chrisdsa/BMS/README.md

# BMS
