chrisdsa/BMS/DOC/Conception/Main.tex

\documentclass[12pt,letterpaper]{article}
\usepackage{hyperref}
\hypersetup{colorlinks=true,allcolors=black}
\usepackage[utf8]{inputenc}
\usepackage[frenchb]{babel}
\usepackage[T1]{fontenc}
\usepackage{ae,aecompl}
\usepackage{pslatex}
\usepackage[top=2cm, bottom=2cm, left=2cm, right=2cm]{geometry}
\usepackage{hhline}
\usepackage{amsmath}
\usepackage{pgfplots}
\pgfplotsset{compat=newest}
\usepackage{multicol}
\usepackage{graphicx}
\graphicspath{{Images/}}
\hyphenpenalty=100
\usepackage{caption}
\usepackage{enumitem}
\usepackage{textcomp}
% Pour multicol (Align top)
\raggedcolumns
% Pour enlever l'indentation et avoir un espace entre les paragraphes
%\usepackage[parfill]{parskip}
\usepackage{float}
\floatstyle{plaintop}
\restylefloat{table}

% Page de garde
\newcommand{\blankpage}{
	\newpage
	\thispagestyle{empty}
	\mbox{}
	\newpage
}

\begin{document}
	
	%====== Page de presentation ======%
	\hypersetup{pageanchor=false}
	\input{./page_presentation.tex}
	\blankpage
	%====== Table des matieres ======%
	\pagenumbering{roman}
	\hypersetup{pageanchor=true}
	\tableofcontents
	%\listoftables
	%\listoffigures	
	\newpage

%====================== INCLUSION DES PARTIES ======================
	\pagenumbering{arabic}
	%====== Introduction ======%	
	\input{Introduction/Introduction.tex}
	%====== Introduction: Rappel de mise en contexte ======%
	\input{Objectifs/Protection_modules.tex}
	%====== Fonctionnalité : Lecture de la tension des modules  ======%
	\input{Fonctionnalites/Lecture_Tension_Module.tex}
	%====== Fonctionnalité : Lecture de la tension de la batterie  ======%
	\input{Fonctionnalites/Lecture_Tension_Batterie.tex}
	%====== Fonctionnalité : Lecture de du courant  ======%
	\input{Fonctionnalites/Lecture_Courant.tex}
	%====== Fonctionnalité : Lecture de la température  ======%
	\input{Fonctionnalites/Lecture_Temperature.tex}
	%====== Fonctionnalité : Détection des seuils et sécurisation de la batterie  ======%
	\input{Fonctionnalites/Detection_seuils_Securisation.tex}
	%====== Fonctionnalité : Controle Contacteur  ======%
	\input{Fonctionnalites/Controle_Contacteurs.tex}
	%====== Fonctionnalité : Avertir l'utilisateur  ======%
	\input{Fonctionnalites/Signalisation_Erreur.tex}	
	%====== Fonctionnalité : Réinitialisation  ======%
	\input{Fonctionnalites/Reinitialisation_Systeme.tex}
	
	%====== Objectif : Balancement des modules ======%
	\input{Objectifs/Balancement.tex}
	\input{Fonctionnalites/Balancement.tex}

	%====== Objectif : Compatibilité avec le BMS présentement utilisé ======%
	\input{Objectifs/Compatibilite.tex}	
	
	%====== Objectif : Facilité les manipulations lors des vérifications techniques ======%
	\input{Objectifs/Manipulations_Verifications_Techniques.tex}

	%====== Architecture ======%
	\input{Architecture/Architecture.tex}
	\input{Architecture/Choix_Technologiques.tex}
	\input{Architecture/Logiciel.tex}
	\input{Architecture/Diagrammes_Fonctionnels.tex}

%====================== Bibliographie ======================

	\begin{thebibliography}{10}
	
	\bibitem{cahier_charge} 
	Christian Daigneault-St-Arnaud, Julien Gagnon-Bourassa, Olivier Cusson-Larocque. \textit{Cahier des charges, Système de protection et de gestion de batterie Li-ion}. \par	
	
	\bibitem{HCNR201} 
	Avago Technologies. \textit{HCNR200 and HCNR201 Data Sheet}.\\ \texttt{\url{https://docs.broadcom.com/docs/AV02-0886EN}}\par
	
	\bibitem{PGA281} 
	Texas Instruments. \textit{PGA281 Data Sheet}.\\ \texttt{\url{http://www.ti.com/lit/ds/symlink/pga281.pdf}}\par

	\bibitem{System_Approach} 
	Phillip Weicker. \textit{A System Approach to Lithium-Ion Battery Management}.\\ \texttt{2014 ARTECH HOUSE}\par	
	
	\bibitem{Lithium_Balance} 
	Lithium Balance. \textit{Battery Management System - Version V6}.\\ \texttt{Application Engineering Manual}\par	

	\bibitem{ASC2018} 
	The Innovators Educational Foundation. \textit{American Solar Challenge 2018 Regulations Revision A}.\\ \texttt{http://americansolarchallenge.org/ASC/wp-content/uploads/2016/08/ASC2018-Regs-External-Revision-A.pdf}\par	
	
	\bibitem{GigavacHX21} 
	Gigavac. \textit{Spécification technique du contacteur HX21}.\\ \texttt{http://www.gigavac.com/sites/default/files/hx21.pdf}\par	

	\bibitem{LiIonBms} 
	Davide Andrea. \textit{Li-Ion BMS: A design guide to DC precharge circuits}.\\ \texttt{http://liionbms.com/php/precharge.php}\par	

	\end{thebibliography}	
	
\end{document}
