chrisdsa/BMS/DOC/Conception/page_presentation.tex

%================ Page titre ================

\title{
	\textbf{Cahier de conception} \\
	\vspace{2cm}
	Système de protection et de gestion de batterie Li-ion	
	}
\author{
	Daigneault-St-Arnaud, Christian, DAIC30099006 \\
	Gagnon-Bourassa, Julien, GAGJ23108601 \\
	Cusson-Larocque, Olivier, CUSO09048905	
}
\newcommand{\cours}{ELE791 - Projets spéciaux }
\newcommand{\prof}{Deslandes, Dominic}

\makeatletter
\begin{titlepage}

	%\pagenumbering{Alph}
	\thispagestyle{empty}
	\centering
	{\Huge \@title}\\ 
	\vspace{2cm}
	{\large Par \\
		\vspace{0.5cm}
		\@author \\
		\vspace{2cm}
		\cours \\
		\vspace{0.5cm}
		\prof \\
		\vspace{3.0cm}
		\@date \\
		\vspace{3.0cm}
		\'{E}COLE DE TECHNOLOGIE SUP\'{E}RIEURE \\
		UNIVERSIT\'{E} DU QUÉBEC
	}
\end{titlepage}
\makeatother
