chrisdsa/BMS/DOC/Conception/Architecture/Logiciel.tex

\subsection{Logiciel}
	\paragraph*{}
	L'architecture logicielle des trois modules est présentée ici sous forme de pile montrant ainsi les interdépendances entre chaque couche. La première couche est pour l'applicatif. On y trouve les différentes tâches que le module doit effectuer. Ensuite viennent la couche des "middlewares", puis celle des services. Les services sont des librairies logicielles contextualisées qui utilisent les pilotes pour effectuer des tâches de plus haut niveau. Les trois dernières couches sont celles des pilotes, de l'abstraction matérielle et des périphériques matériels internes.

	\newpage
	\subsubsection*{Module maître}
		\noindent
		Interruptions : Base de temps du HAL, base de temps du RTOS, CAN \#1 (Tx et Rx),  CAN \#2 (Tx et Rx) \\
		Interrogations : ADC interne thermistor (x1), Bouton de reprise d’erreur
		\begin{figure}[H]
			\centering
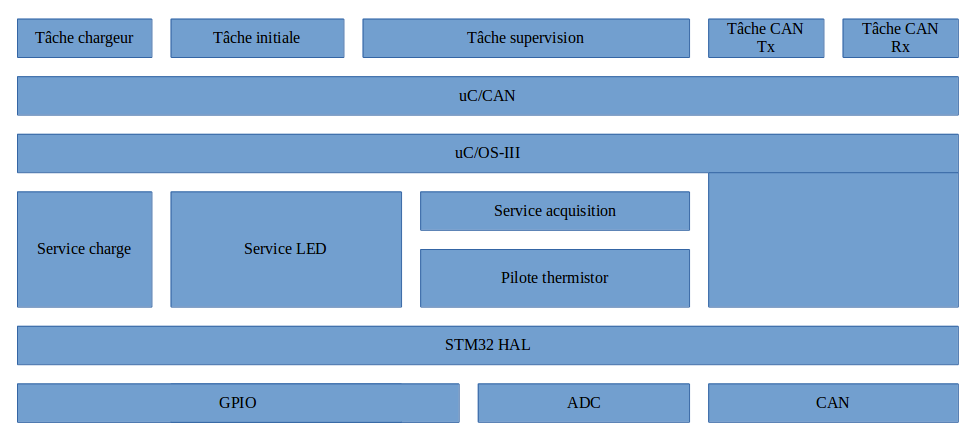
[picture p2: DOC/Conception/Images/Logiciel_Master.png]
			\fbox{}
			\caption{Logiciel du module maître}
			\label{fig:logiciel_master}
		\end{figure}

	\subsubsection*{Module esclave}
		\noindent
		Interruptions : Base de temps du HAL, base de temps du RTOS, CAN \#1 (Tx et Rx) \\
		Interrogations : ADC externe cellules (x8), ADC interne thermistor (x2)
		\begin{figure}[H]
			\centering
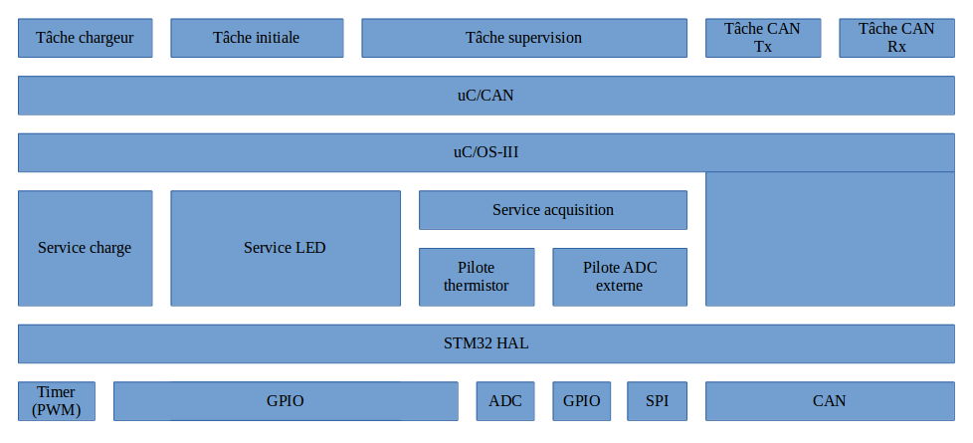
[picture p3: DOC/Conception/Images/Logiciel_Slave.png]
			\fbox{}
			\caption{Logiciel du module esclave}
			\label{fig:logiciel_slave}
		\end{figure}

	\newpage
	\subsubsection*{Module de lecture de courant}
		\noindent
		Interruptions : Base de temps du HAL, base de temps du RTOS, CAN \#1 (Tx et Rx) \\
		Interrogations : ADC externe shunt
		\begin{figure}[H]
			\centering
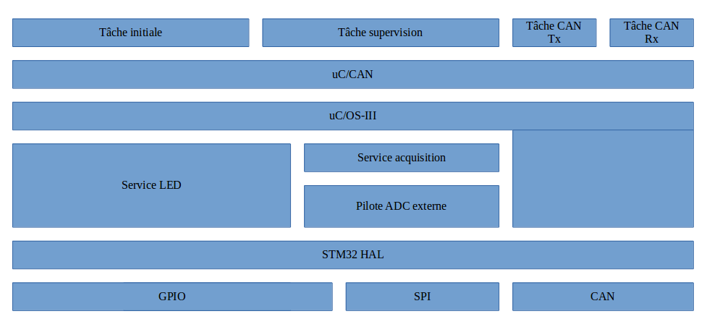
[picture p4: DOC/Conception/Images/Logiciel_Current_Sense.png]
			\fbox{}
			\caption{Logiciel du module de lecture de courant}
			\label{fig:logiciel_current_sense}
		\end{figure}
