chrisdsa/BMS/DOC/Conception/Objectifs/Balancement.tex

\section{Balancement des modules}
	\paragraph*{}
	Les différents modules qui composent la batterie n'ont pas exactement la même capacité et la même résistance en série. Ces différences font en sorte que les modules n'atteindront pas un état de charge complet en même temps. Lorsque la batterie est à la fin de sa recharge, les modules doivent être balancés pour que la batterie puisse atteindre un état de charge de 100\%. Lors de la compétition, la batterie n'atteint pas un état de charge assez élevé pour balancer les modules, cette étape a donc seulement lieu avant le début de la course. Il existe plusieurs stratégies de balancement qui varient en complexité, en robustesse et en efficacité.
