chrisdsa/BMS/DOC/Cahier de charge/Specification/Specification.tex

\section{Spécifications}
	\paragraph{}
	Les spécifications du projet sont majoritairement tirées du guide d'inspection qui va être utilisé par les organisateurs de la compétition \cite{BMS_inspection}. Les spécifications pour les fonctionnalités et objectifs pour la compétition ASC 2018 seront déterminés en automne.
	
	\begin{table}[H]
		\centering
		\caption{Spécifications pour ELE-791}
		\renewcommand{\arraystretch}{1.3}
		\begin{tabular}{|c|c|c c|c|}
			\hline
			\textbf{Fonctionnalités}& \textbf{Paramètres} & \textbf{MIN} & \textbf{MAX} 	& \textbf{Unité}	\\ \hhline{|=|=|==|=|}
			\multirow{2}{5cm}{Lecture de tension des modules}  & Tension d'entrée & 2 & 5 	   	&    V 				\\ \hhline{|~|-|--|-|}
											&   Résolution	 	& $\pm10$		&	  	   		&  	mV				\\ \hline
			\multirow{2}{5cm}{Lecture de courant} & Courant 	& 				&			   	&	A				\\ \hhline{|~|-|--|-|}
											&	Résolution		&				&	$\pm2$		&	\%				\\ \hline
			\multirow{2}{5cm}{Lecture de température}& Région d'opération & -10	&		85		& $\degres \text{C}$\\ \hhline{|~|-|--|-|}
											&	Résolution		&	$\pm2$		&				&$\degres \text{C}$	\\ \hline
			\multirow{1}{5cm}{Balancement}	& Écart Vmin et Vmax&				&  		50		&   mV				\\ \hline
			\multirow{1}{5cm}{Faciliter les manipulations}& Manipulation &		&       12 		& 		 			\\ \hline
			\multirow{1}{5cm}{Détection d'une faute}	& Délais &	 			&   	200	  	& 	ms 				\\ \hline
			\multirow{2}{5cm}{Sécuriser la batterie}	& Délais &	 			&   	200	  	& 	ms 				\\ \hhline{|~|-|--|-|}
											& Tension aux bornes de la batterie  &        &	0	&	V				\\ \hhline{|~|-|--|-|}
											& Courant lorsque charge est branchée &		&	0	&	A				\\ \hline
			\multirow{1}{5cm}{Précharge}	&       Temps 		&	 			&   	10	  	& 	s 				\\ \hline
			
		\end{tabular}
	\end{table}
