chrisdsa/BMS/DOC/Proposition de projet/page_presentation.tex

%====== Page de presentation ======%

\title{Proposition de projet}
\title{Système de protection de batterie Li-ion}
\author{
	Daigneault-St-Arnaud, Christian, DAIC30099006 \\
	Gagnon-Bourassa, Julien, GAGJ23108601 \\
	Cusson-Larocque, Olivier, CUSO09048905
}
\newcommand{\cours}{ELE791 - Projets sp\'{e}ciaux }
\newcommand{\prof}{Deslandes, Dominic}

\makeatletter
\begin{titlepage}
	\begin{center}
	\pagenumbering{gobble}
	{\Huge \@title}\\ 
	\vspace{3cm}
	{\large Par \\
		\vspace{0.5cm}
		\@author \\
		\vspace{3cm}
		\cours \\
		\vspace{0.5cm}
		\prof \\
		\vspace{3.5cm}
		\@date \\
		\vspace{3.5cm}
		\'{E}COLE DE TECHNOLOGIE SUP\'{E}RIEURE \\
		UNIVERSIT\'{E} DU QUÉBEC
	}		
	\end{center}
\end{titlepage}
\makeatother
