chrisdsa/BMS/DOC/Realisation/RappelDesObjectifs/RappelDesObjectifs.tex

\section{Rappel des objectifs}

	\paragraph{}
	L’équipe s’est fixé des objectifs au début du projet qui étaient réalisables dans le cadre du cours d’ELE791. Les objectifs sont les suivants :

	\subsection{Protection des modules}
	
		\paragraph{}
		La protection des modules inclut la détection de surtension, de sous-tension, de surintensité et de surchauffe. À la suite d’une détection d’erreur, les contacteurs doivent s’ouvrir dans un délai de moins de deux secondes et un témoin lumineux doit avertir l’utilisateur. Le système de protection et de gestion de batterie doit être redémarré par l’utilisateur, s’il n’y a plus d’erreur.

	\subsection{Balancement des modules}

		\paragraph{}
		Comme les modules n’ont pas tous la même capacité, des débalancements peuvent survenir lorsque la batterie est presque pleine ou presque vide. Pour éliminer ces débalancements, il faut saigner (bleeder) les modules, c’est-à-dire décharger les modules déséquilibrés pour les amener au même niveau de charge.
		
	\subsection{Compatibilité avec le BMS Lithium Balance}

		\paragraph{}
		Éclipse utilise présentement le BMS de Lithium Balance. Celui-ci est fonctionnel, mais il n’offre pas la possibilité de faire des modifications. Éventuellement, il sera remplacé par le projet actuel lorsqu'il sera jugé terminé. Par contre, si jamais un problème survient en compétition, les connexions doivent être les mêmes pour facilement remplacer le nouveau BMS par l’ancien. Ce faisant, le projet doit inclure les fonctionnalités offertes par le BMS de Lithium Balance.

	\subsection{Facilitation des manipulations lors des vérifications techniques}

		\paragraph{}
		Une des raisons de fabriquer le système de protection et de gestion de batterie est de faciliter les manipulations durant la vérification technique des compétitions du club Éclipse. Avec le BMS actuel, les manipulations sont assez difficiles à effectuer. Il faut donc, avec le moins de manipulations possible, aisément passer les tests de la vérification technique du BMS.
