chrisdsa/BMS/DOC/Cahier de charge/Echeancier/Echeancier.tex

\section{Échéancier}

	\subsection{Dates importantes}
	
		\begin{multicols}{2}

		\paragraph{}
		Semaine 1 (1 mai - 7 mai)
			\begin{description}
				\item[$\bullet$] 1er mai : Début du projet
				\item[$\bullet$] Début de la rédaction du cahier des charges
				\item[$\bullet$] Recherche de documentations techniques
			\end{description}
	
		\paragraph{}
		Semaine 2 (8 mai - 14 mai)
			\begin{description}
				\item[$\bullet$] Rencontre avec le professeur
				\item[$\bullet$] Rédaction du cahier des charges
			\end{description}
		
		\paragraph{}
		Semaine 3 (15 mai - 21 mai)
			\begin{description}
				\item[$\bullet$] 15 mai: Remise du cahier des charges
				\item[$\bullet$] Début de la rédaction du cahier de conception
				\item[$\bullet$] Veille technologique
				\item[$\bullet$] Génération d'idées pour le système					
			\end{description}
		
		\paragraph{}
		Semaine 4 (22 mai - 28 mai)
			\begin{description}
				\item[$\bullet$] Rencontre avec le professeur
				\item[$\bullet$] 22 mai: Congé férié				
				\item[$\bullet$] Décomposition fonctionnelle
				
			\end{description}
		
		\paragraph{}
		Semaine 5 (29 mai - 4 juin)
			\begin{description}
				\item[$\bullet$] Sélection des solutions	
				\item[$\bullet$] Validation des solutions
			\end{description}

		\paragraph{}
		Semaine 6 (5 juin - 11 juin)
			\begin{description}
				\item[$\bullet$] Rencontre avec le professeur
				\item[$\bullet$] Choix de la solution			

			\end{description}		
		
		\paragraph{}
		Semaine 7 (12 juin - 18 juin)
			\begin{description}
				\item[$\bullet$] 12 juin: Remise du cahier de conception
			\end{description}
		
		\paragraph{}
		Semaine 8 (19 juin - 25 juin)
			\begin{description}
				\item[$\bullet$] Rencontre avec professeur
				\item[$\bullet$] 23 juin: Congé férié
				\item[$\bullet$] Début de la rédaction du rapport final
				
			\end{description}
		\columnbreak
		\paragraph{}
		Semaine 9 (26 juin - 2 juillet)
			\begin{description}
				\item[$\bullet$] 30 juin: Congé férié
				\item[$\bullet$] Schématisation	des circuits		
		\end{description}

		\paragraph{}
		Semaine 10 (2 juillet - 9 juillet)
			\begin{description}
				\item[$\bullet$] Rencontre avec professeur
				\item[$\bullet$] Création des PCBs
				\item[$\bullet$] Achat des pièces				
			\end{description}		
		
		\paragraph{}
		Semaine 11 (10 juillet - 16 juillet)
			\begin{description}
				\item[$\bullet$] Tests du prototype
			\end{description}

		\paragraph{}
		Semaine 12 (17 juillet - 23 juillet)
			\begin{description}
				\item[$\bullet$] Rencontre avec professeur
				\item[$\bullet$] Correction du prototype				
			\end{description}		
		
		\paragraph{}
		Semaine 13 (24 juillet - 30 juillet)
			\begin{description}
				\item[$\bullet$] Validation des corrections du prototype
			\end{description}
		
		\paragraph{}
		Semaine 14 (31 juillet - 6 août)
			\begin{description}
				\item[$\bullet$] 2 août: Remise du rapport final
			\end{description}	
			
		\paragraph{}
		Semaine 15 (7 août - 13 août)
			\begin{description}		
				\item[$\bullet$] Présentation orale
			\end{description}	
		\end{multicols}
