chrisdsa/BMS/DOC/Misc/historique-bms.odt

Historique du BMS de E7 à E10

Éclipse 7

BMS fait par l’équipe sous forme maître/esclave basé sur le LTC6802. Il n’offrait pas de SOC. L’équipe participe à la World Solar Challenge 2011.

Éclipse 8

BMS qui reprend le desgin d’Éclipse 7 mais qui ajoute la fonction de SOC. L’équipe participe à la World Solar Challenge 2013.

Éclipse 8.1

L’équipe se prépare pour l’American Solar Challenge 2014, une compétition beaucoup plus sévère sur l’aspect sécurité. Le BMS utilisé par Éclipse 8 offrait une certaine protection, mais en dehors des limites acceptées par la ASC. Un redesign majeur aurait été nécessaire et la main d’oeuvre et le temps manquaient. L’équipe décide donc d’investir dans un BMS commercial. Celui-ci offre toutes la précision et les fonctionnalités nécessaires, sauf la protection de courant trop élevé qui est implémenté sur le module d’alimentation du véhicule.

Éclipse 9

Lors du retour de compétition d’Éclipse 8.1, un incident pendant le transport endommage la batterie ainsi que le BMS. Le manufacturier du BMS n’en fabrique plus et les pièces de rechange sont impossible à avoir. L’équipe, encore en manque de main d’oeuvre, décide d’acheter de nouveau un BMS commercial. L’équipe participe à l’American Solar Challenge 2016. Le test de sécurité du BMS leur donne du fil à retorde. Certaines manipulations sont difficiles à exécuter sur le BMS commercial utilisé.

Éclipse 10

Trois membres du club en fin de BAC décide de concevoir et de réaliser un nouveau BMS assez solide pour la ASC 2018, qui facilitera les manipulations pour les tests de sécurité et qui offrira toute la flexibilité voulu étant donné que le code source sera modifiable contrairement à une solution commerciale. De plus, ce projet est en ligne avec la philosophie du club qu’est de concevoir et de réaliser le plus de circuits possibles par soi-même.

Historique des IC utilisés pour E7/E8

Éclipse 7

Puppets V1 : ATTINY84-20SSU

Puppets V2 : LTC6802-1

Puppets V2.1 : LTC6802-1

Puppets V3 : LTC6802-2

Puppets V4 : LTC6803-4

Éclipse 8

Puppets V5 : LTC6803-4

Puppets V6 : LTC6802-2

Puppets V7 : LTC6802-2

Information sur les LTC

The LTC6803-2 connects the bottom of the stack to V⁻ internally. It is pin compatible with the LTC6802-2, providing a drop-in upgrade. The LTC6803-4 separates the bottom of the stack from V⁻, improving cell 1 measurement accuracy.

Pour le nouveau LTC6804, il y a 2 modèles. Le LTC6804-1 qui est l’équivalent du LCT6803-3 et le LTC6804-2 qui est l’équivalent du LTC6804-4. Il n’y a plus de modèle sans « isolated V- ».

Demo Board pour le LTC6804-2 : DC1942C (150$)

On peut l’interfacer avec un autre board qui se branche sur un PC par USB, le DC590 (50$).
