chrisdsa/BMS/DOC/Conception/Architecture/Architecture.tex

\section{Architecture}

	\subsection{Architecture générale}
		\begin{figure}[H]
			\centering
			\fbox{}
			\caption{Architecture générale du système de protection et de contrôle}
			\label{fig:architecture_generale}
		\end{figure}

	\subsection{Architecture du module de lecture de courant}
		\begin{figure}[H]
			\centering
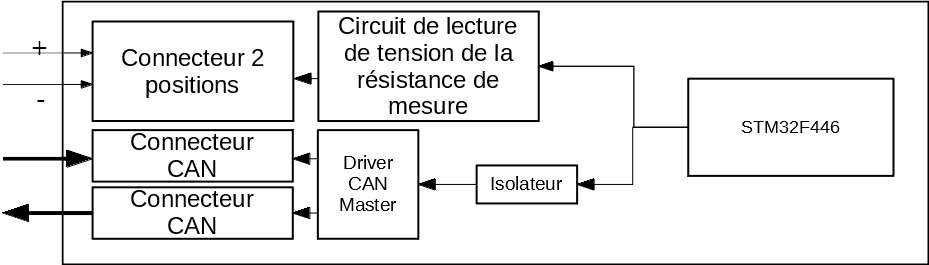
[picture p47: DOC/Conception/Images/Architecture_LectureCourant.png]
			\fbox{}
			\caption{Architecture du module de lecture de courant}
			\label{fig:architecturelecturecourant}
		\end{figure}
	\subsection{Architecture du module maître}

		\begin{figure}[H]
			\centering
			\fbox{}
			\caption{Architecture du module maître}
			\label{fig:architecture_master}
		\end{figure}

	\subsection{Architecture du module esclave}

	\begin{figure}[H]
		\centering
		\fbox{}
		\caption{Architecture du module esclave}
		\label{fig:architecture_slave}
	\end{figure}
