chrisdsa/BMS/DOC/Conception/Architecture/Diagrammes_Fonctionnels.tex

\section{Annexes: Diagrammes fonctionnels}

	\subsection{Module maître}

		\begin{figure}[H]
			\centering
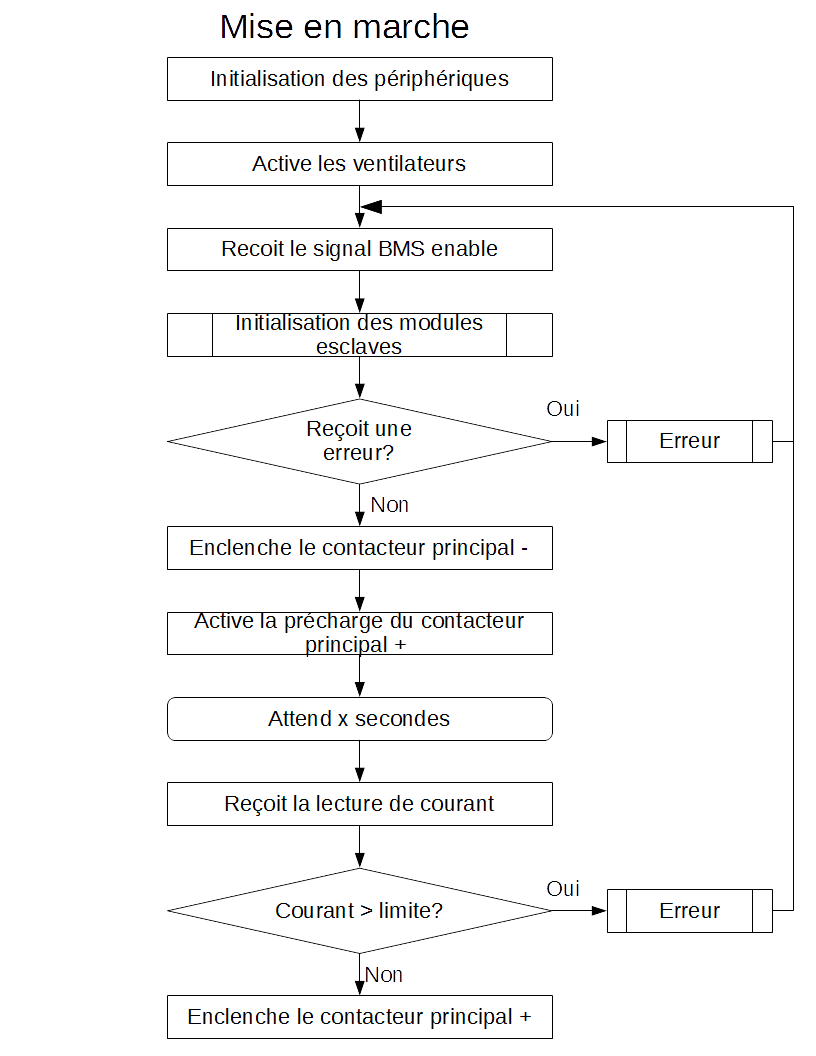
[picture p48: DOC/Conception/Images/DiagrammeFonctionnel_MiseEnMarche.png]
			\fbox{}
			\caption{Diagramme module maître: Mise en marche}
			\label{fig:diagrammefonctionnelmiseenmarche}
		\end{figure}

		\begin{figure}[H]
			\centering
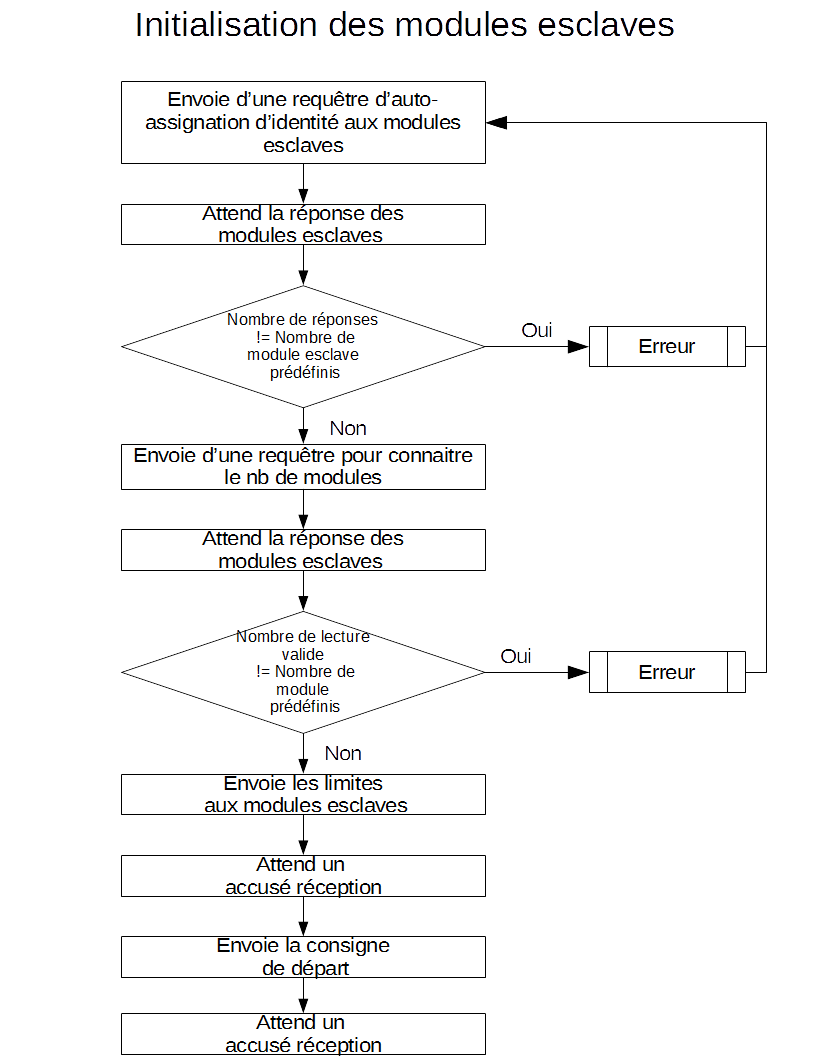
[picture p49: DOC/Conception/Images/DiagrammeFonctionnel_MaitreInitEsclave.png]
			\fbox{}
			\caption{Diagramme module maître: Initialisation des modules esclaves}
			\label{fig:diagrammefonctionnelmaitreinitesclave}
		\end{figure}

		\begin{figure}[H]
			\centering
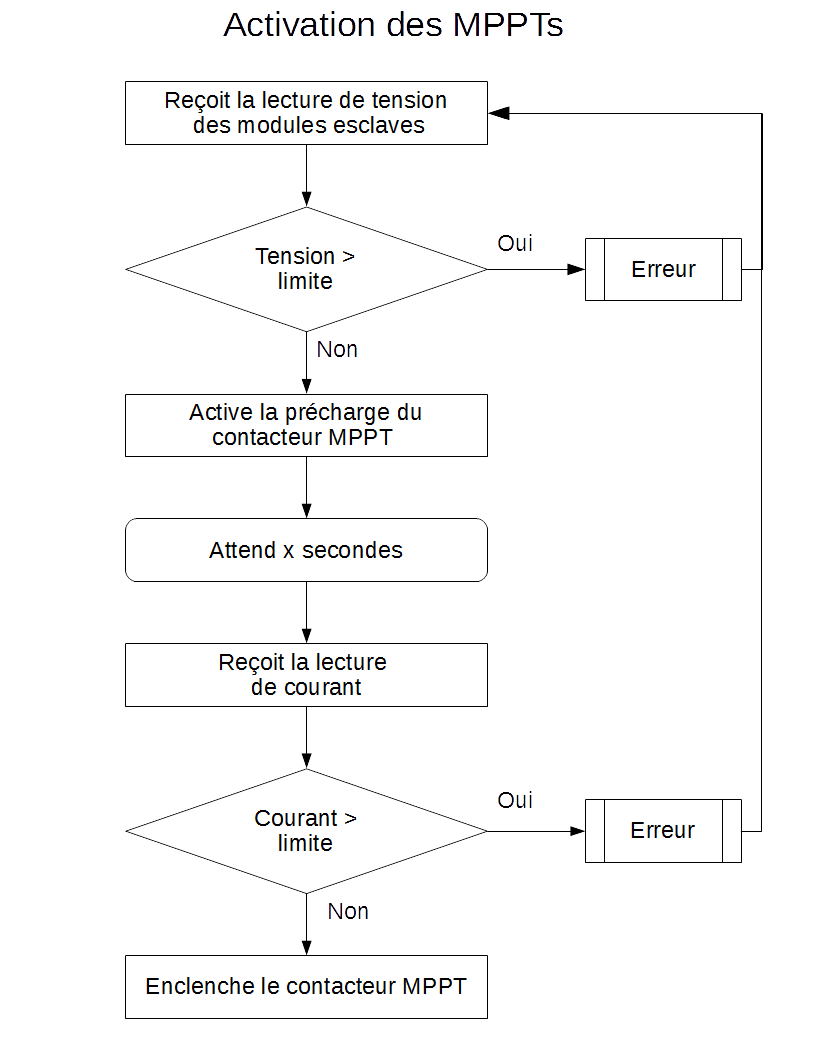
[picture p50: DOC/Conception/Images/DiagrammeFonctionnel_ActivationMppt.png]
			\fbox{}
			\caption{Diagramme module maître: Activation des MPPTs}
			\label{fig:diagrammefonctionnelactivationmppt}
		\end{figure}

		\begin{figure}[H]
			\centering
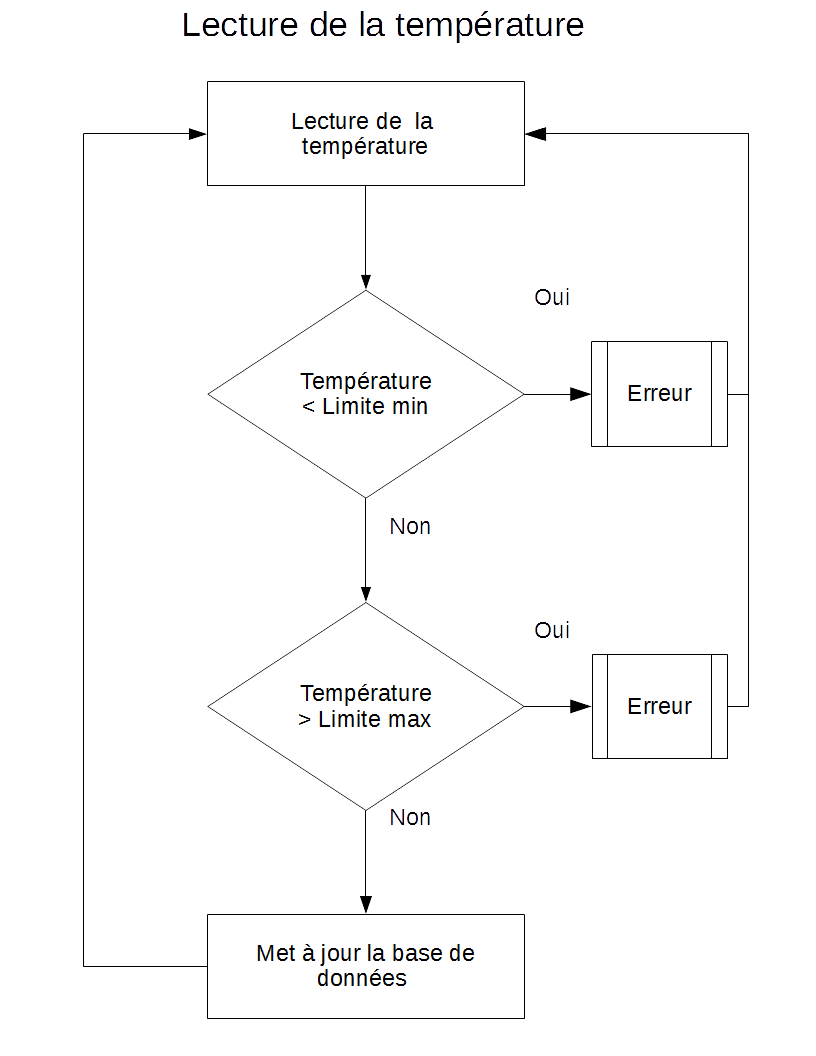
[picture p51: DOC/Conception/Images/DiagrammeFonctionnel_MaitreLectureTemp.png]
			\fbox{}
			\caption{Diagramme module maître: Lecture de la température}
			\label{fig:diagrammefonctionnelmaitrelecturetemp}
		\end{figure}

		\begin{figure}[H]
			\centering
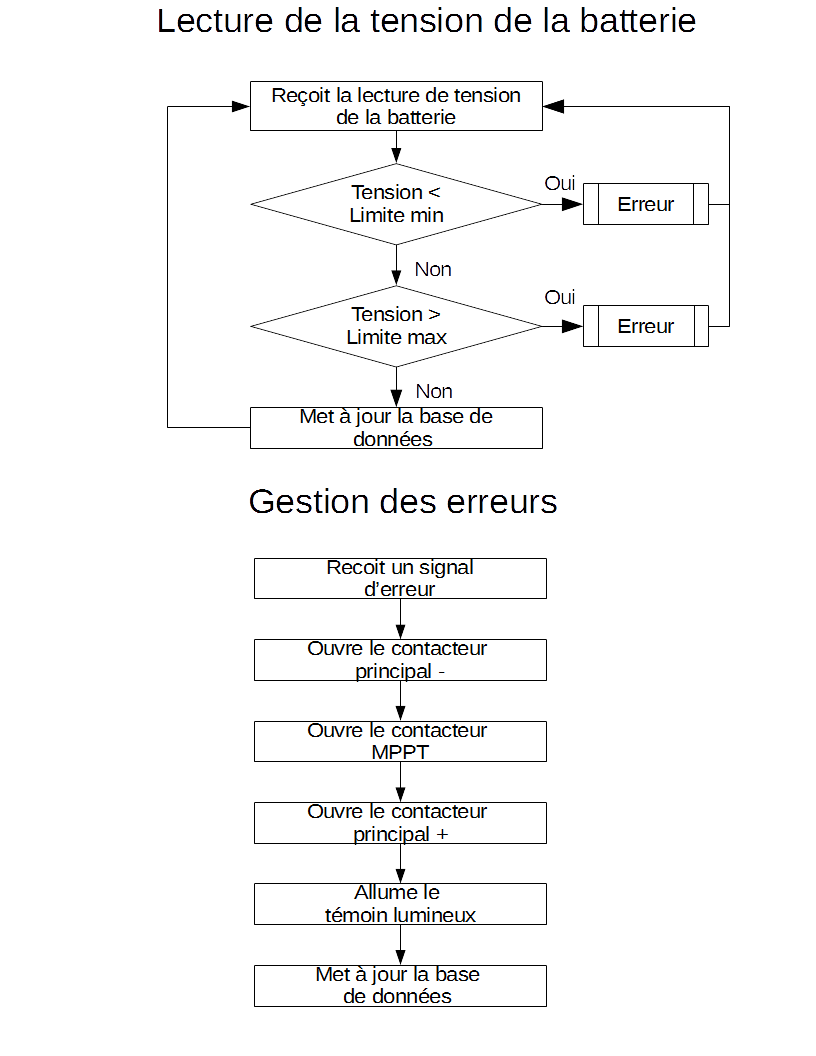
[picture p52: DOC/Conception/Images/DiagrammeFonctionnel_MaitreLectureBat.png]
			\fbox{}
			\caption{Diagramme module maître: Lecture de la tension de la batterie + Gestion des erreurs}
			\label{fig:diagrammefonctionnelmaitrelecturebat}
		\end{figure}

		\begin{figure}[H]
			\centering
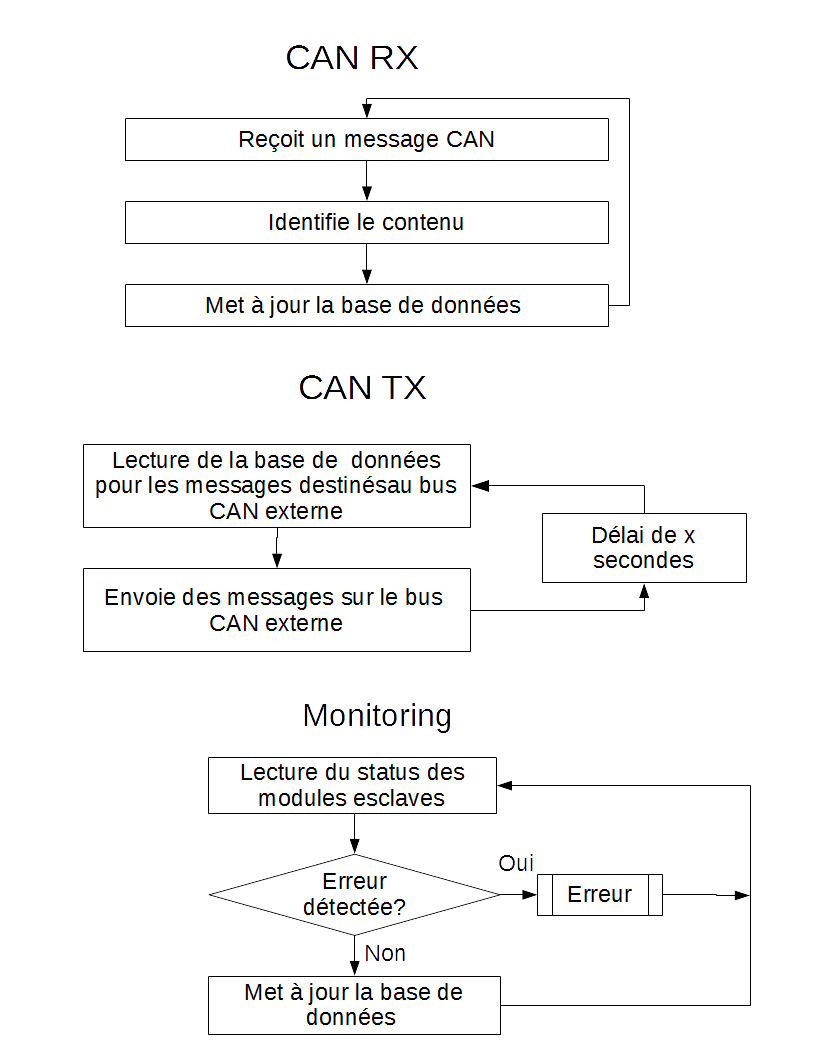
[picture p53: DOC/Conception/Images/DiagrammeFonctionnel_CanMonitoring.png]
			\fbox{}
			\caption{Diagramme module maître: CAN RX + CAN TX + Monitoring }
			\label{fig:diagrammefonctionnelcanmonitoring}
		\end{figure}

	\subsection{Module esclave}

		\begin{figure}[H]
			\centering
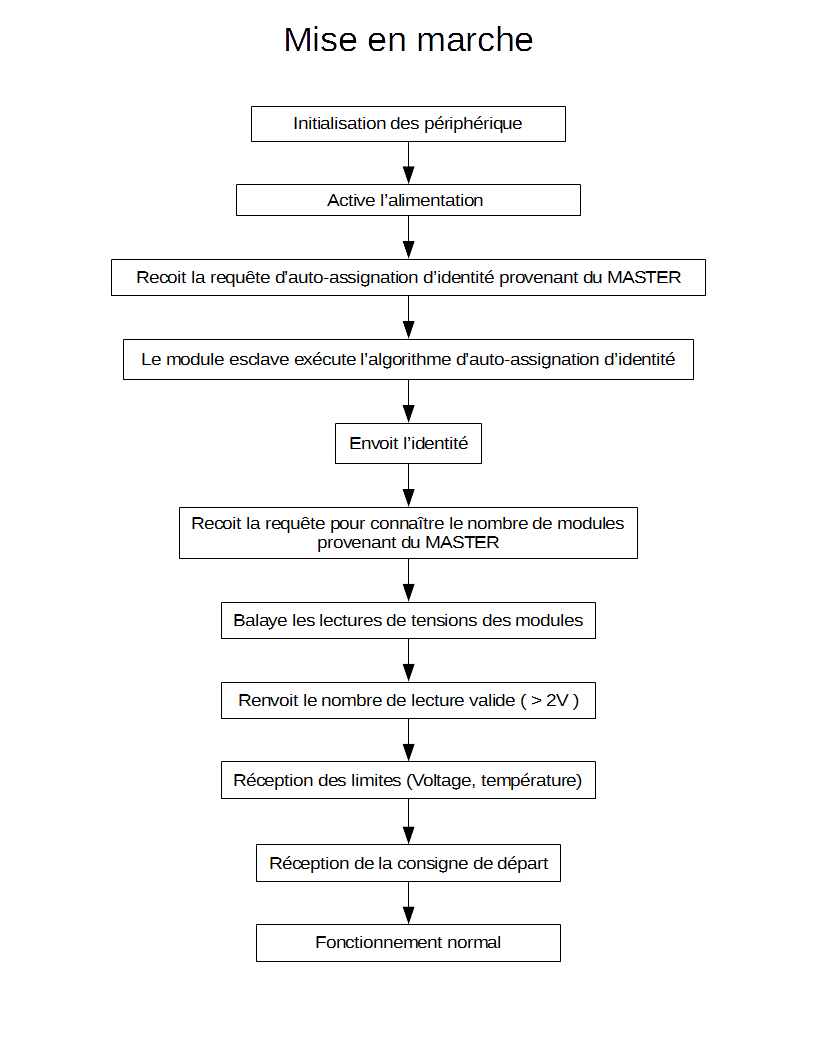
[picture p54: DOC/Conception/Images/DiagrammeFonctionnel_SlaveMiseEnMarche.png]
			\fbox{}
			\caption{Digramme module esclave: Mise en marche}
			\label{fig:diagrammefonctionnelslavemiseenmarche}
		\end{figure}

		\begin{figure}[H]
			\centering
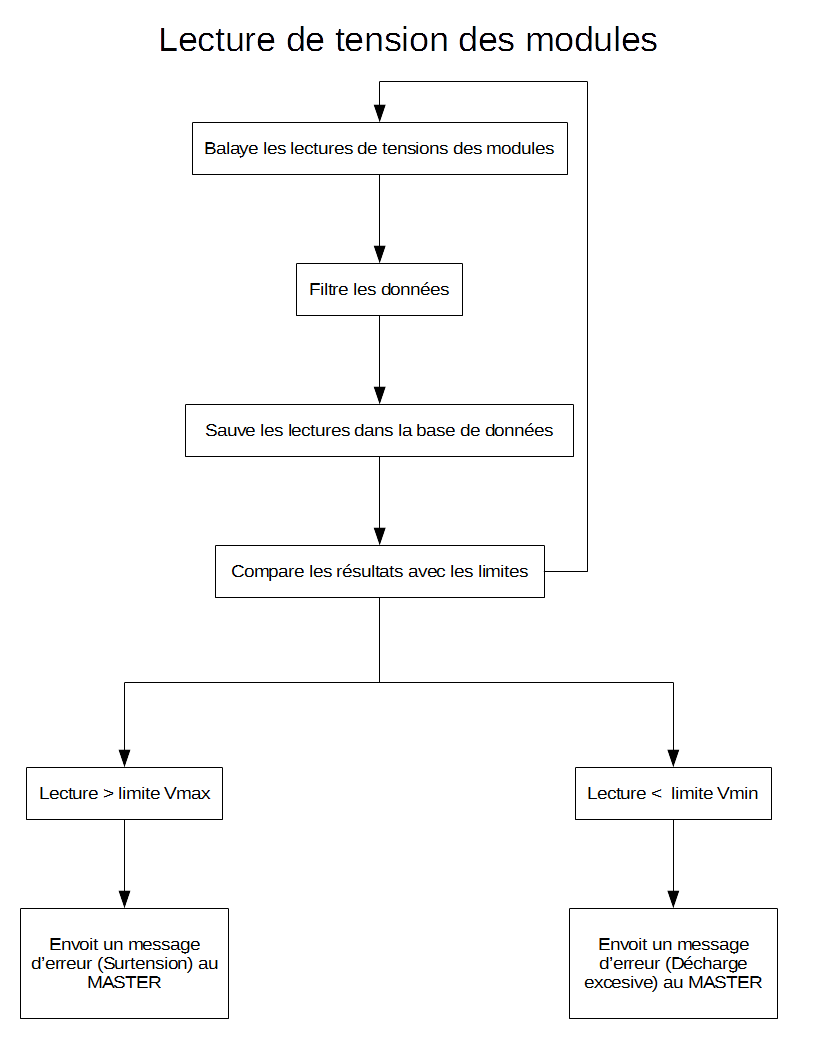
[picture p55: DOC/Conception/Images/DiagrammeFonctionnel_SlaveLectureDeTension.png]
			\fbox{}
			\caption{Diagramme module esclave: Lecture de tension des modules}
			\label{fig:diagrammefonctionnelslavelecturedetension}
		\end{figure}

		\begin{figure}[H]
			\centering
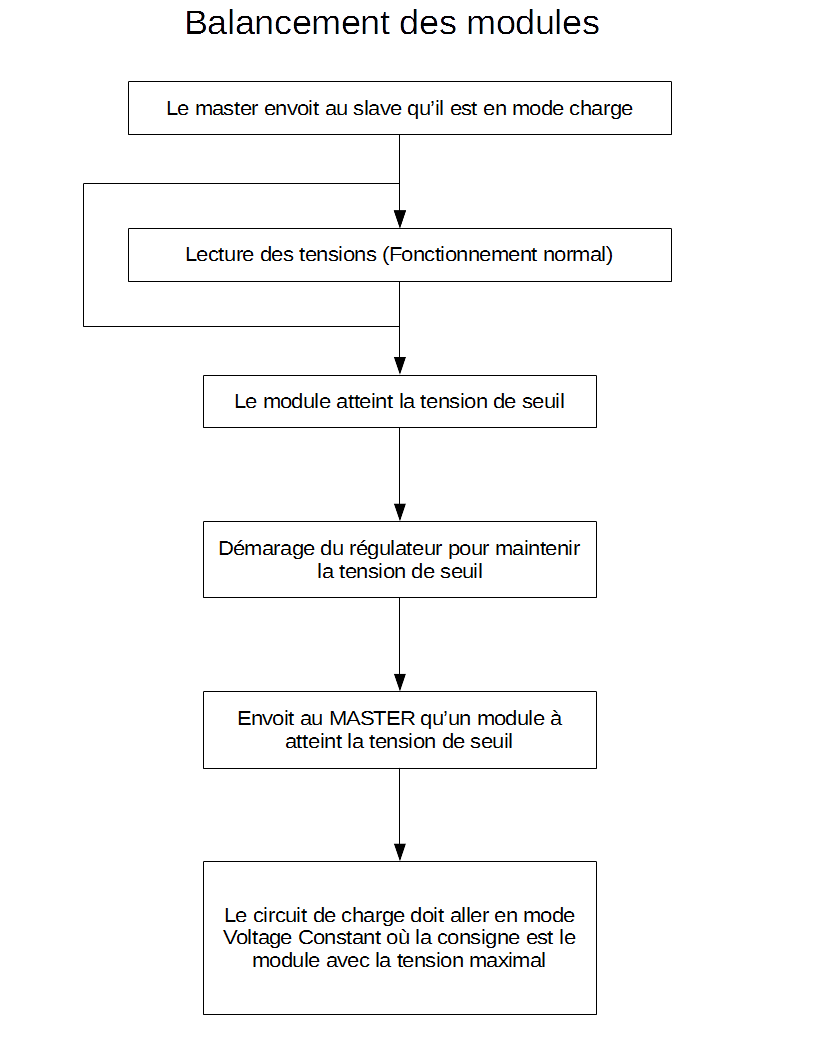
[picture p56: DOC/Conception/Images/DiagrammeFonctionnel_SlaveBalancement.png]
			\fbox{}
			\caption{Diagramme module esclave: Balancement des modules}
			\label{fig:diagrammefonctionnelslavebalancement}
		\end{figure}

		\begin{figure}[H]
			\centering
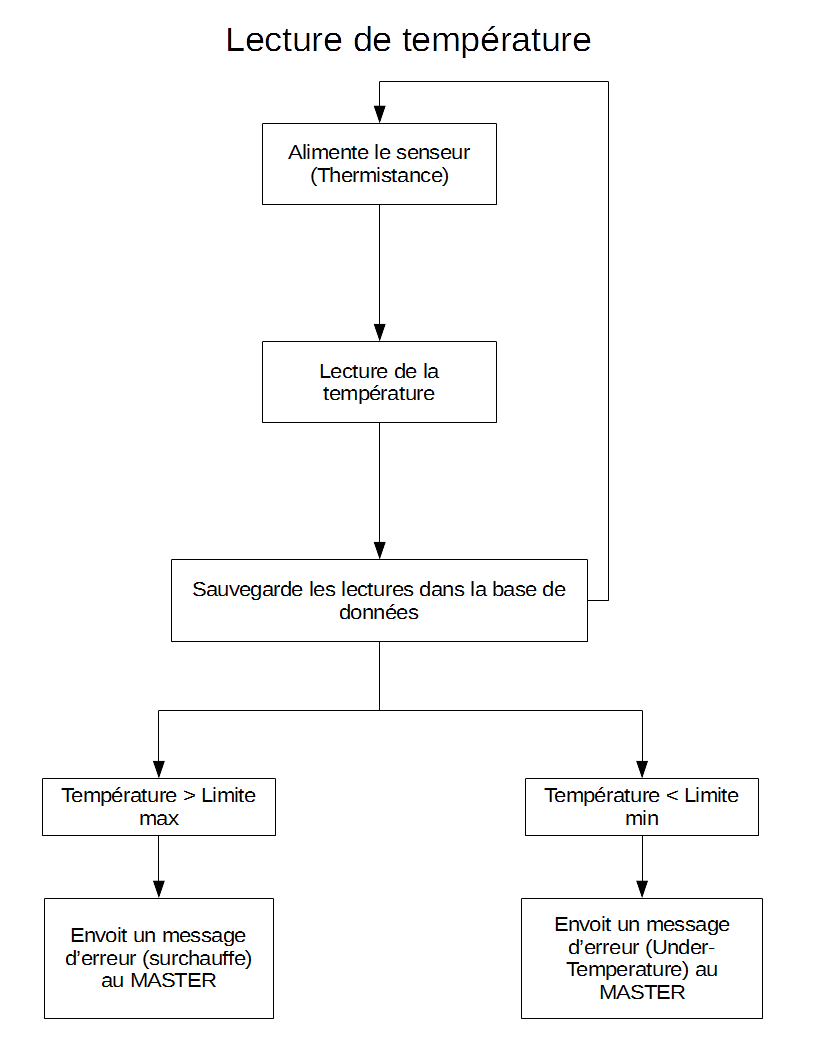
[picture p57: DOC/Conception/Images/DiagrammeFonctionnel_SlaveLectureTemperature.png]
			\fbox{}
			\caption{Diagramme module esclave: Lecture de température}
			\label{fig:diagrammefonctionnelslavelecturetemperature}
		\end{figure}

		\begin{figure}[H]
			\centering
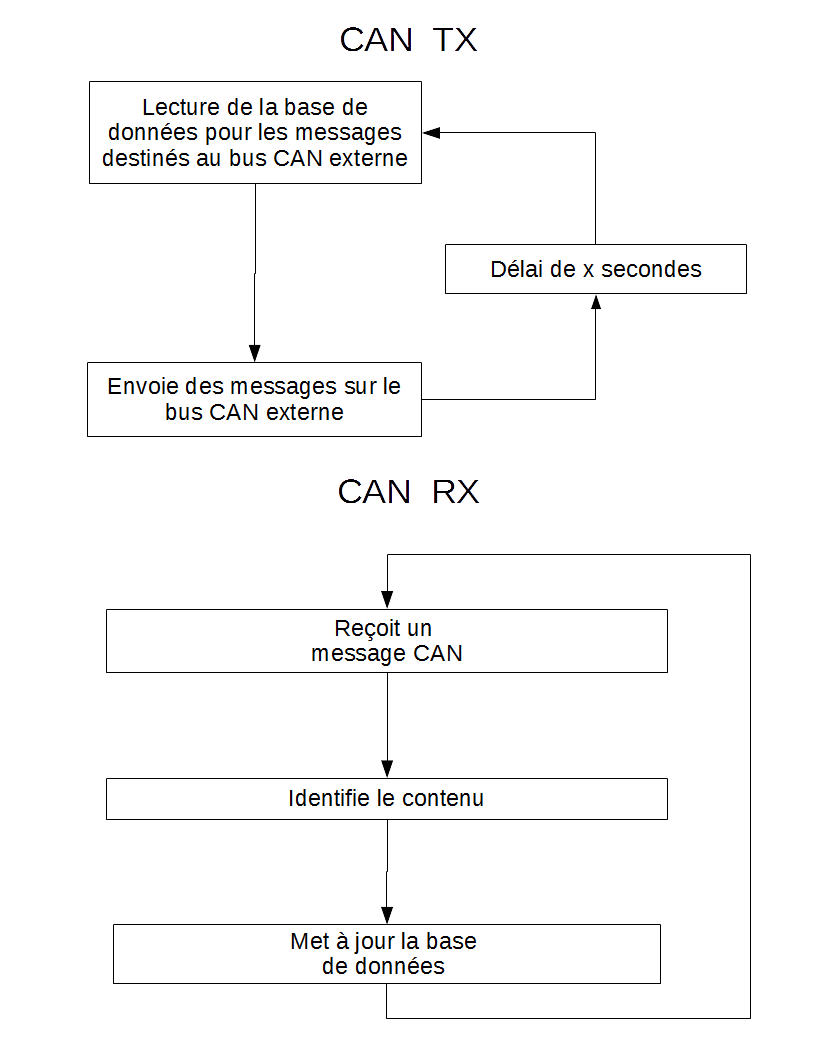
[picture p58: DOC/Conception/Images/DiagrammeFonctionnel_SlaveCan.png]
			\fbox{}
			\caption{Diagramme module esclave: CAN TX + CAN RX}
			\label{fig:diagrammefonctionnelslavecan}
		\end{figure}

	\subsection{Module de lecture de courant}

		\begin{figure}[H]
			\centering
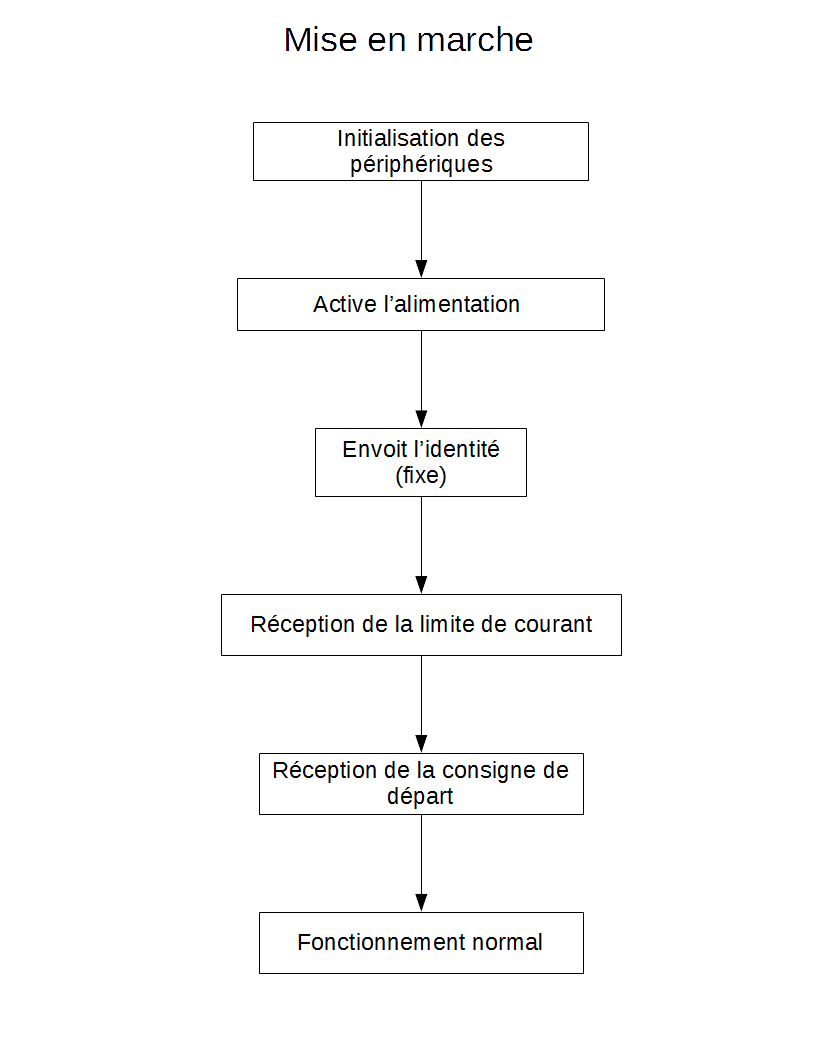
[picture p59: DOC/Conception/Images/DiagrammeFonctionnel_CurrentMiseEnMarche.png]
			\fbox{}
			\caption{Diagramme module de lecture de courant: Mise en marche}
			\label{fig:diagrammefonctionnelcurrentmiseenmarche}
		\end{figure}

		\begin{figure}[H]
			\centering
			\fbox{}
			\caption{Diagramme module de lecture de courant: Lecture de courant}
			\label{fig:diagrammefonctionnelcurrentlecture-de-courant}
		\end{figure}

		\begin{figure}[H]
			\centering
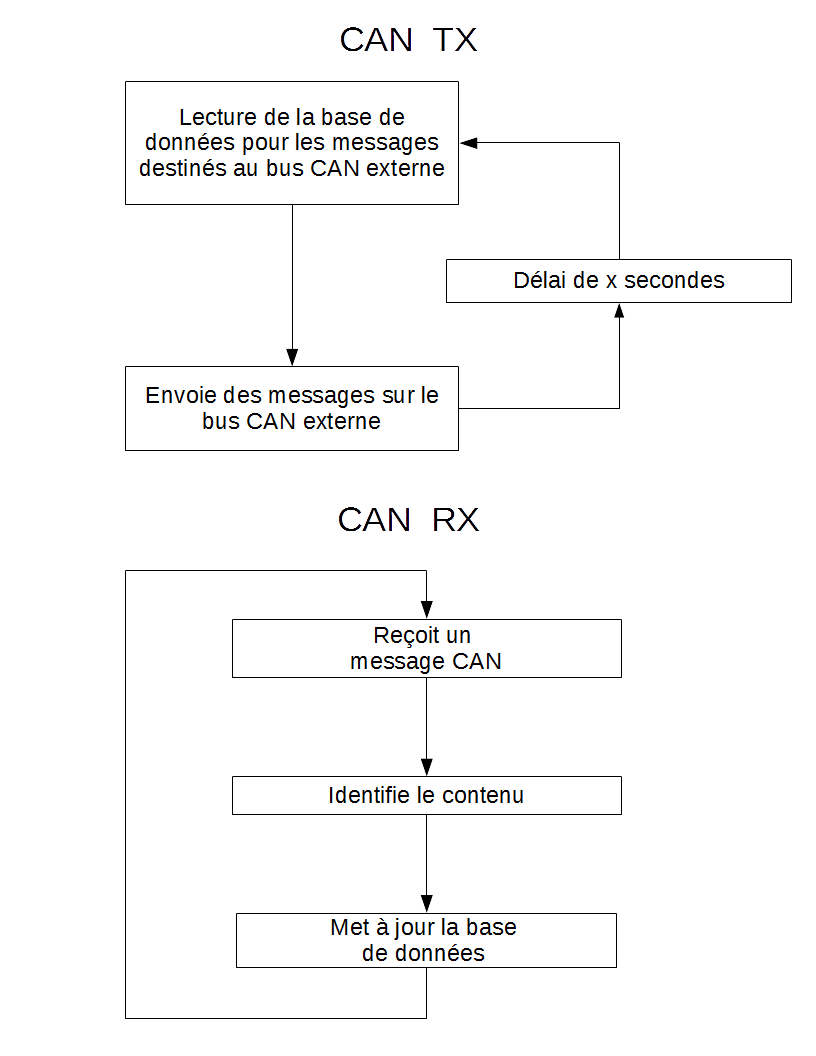
[picture p60: DOC/Conception/Images/DiagrammeFonctionnel_CurrentCan.png]
			\fbox{}
			\caption{Diagramme module de lecture de courant: CAN TX + CAN RX}
			\label{fig:diagrammefonctionnelcurrentcan}
		\end{figure}

\newpage
