chrisdsa/BMS/DOC/Conception/Introduction/DescriptionParties.tex

\subsection*{Stratégies de balancement}
\paragraph*{}
