chrisdsa/BMS/DOC/Conception/Images/Architecture_generale.png

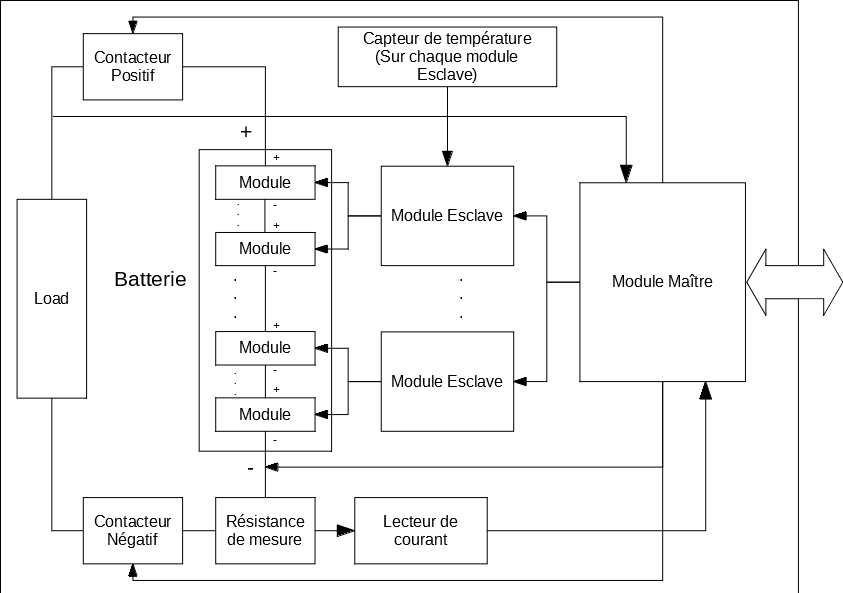
DOC/Conception/Images/Architecture_generale.png
