chrisdsa/BMS/DOC/Conception/Images/Architecture_Master.png

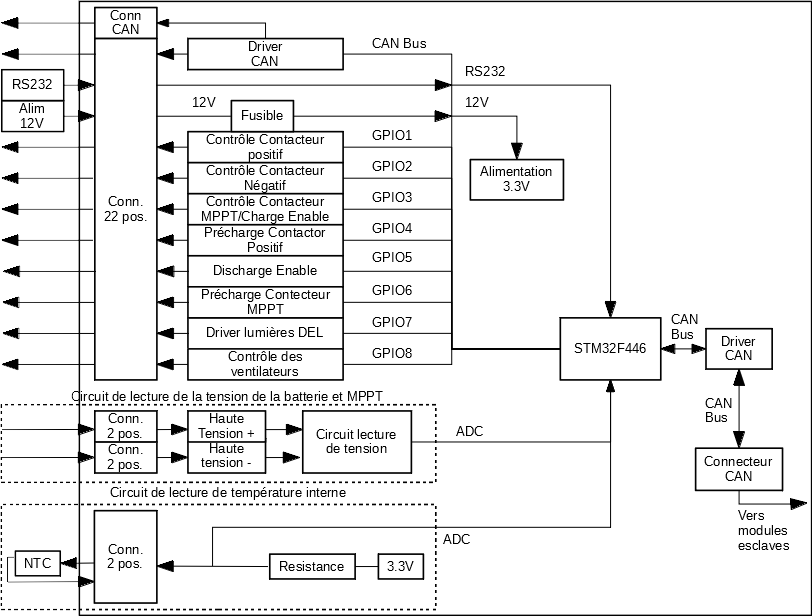
DOC/Conception/Images/Architecture_Master.png
