chrisdsa/BMS/DOC/Conception/Images/Architecture_Slave.png

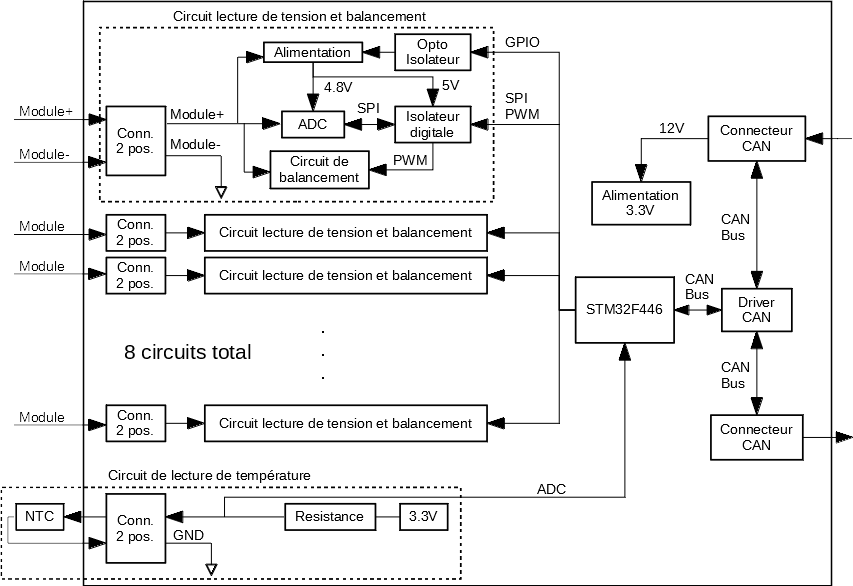
DOC/Conception/Images/Architecture_Slave.png
