chrisdsa/BMS/DOC/Conception/Images/DualContactorDrive.png

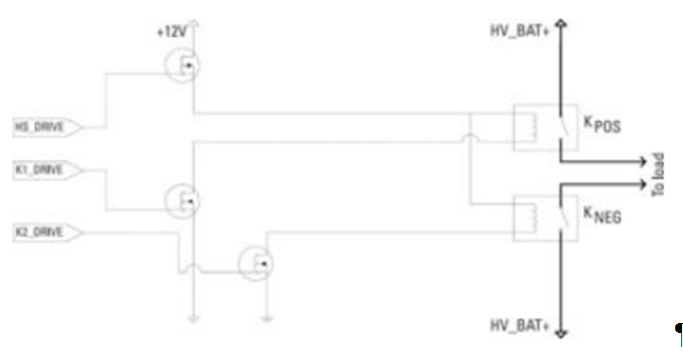
DOC/Conception/Images/DualContactorDrive.png
