chrisdsa/BMS/DOC/Conception/Images/LithiumBalancePinout.png

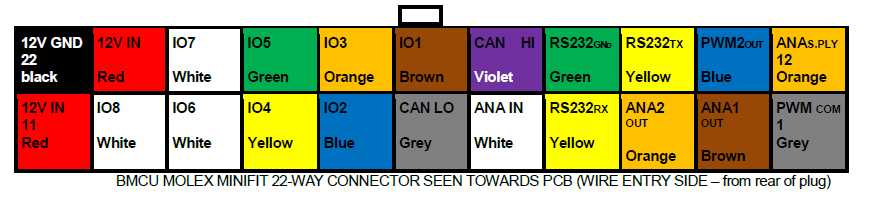
DOC/Conception/Images/LithiumBalancePinout.png
