chrisdsa/BMS/DOC/Conception/Images/SchemaCourbePrecharge.png

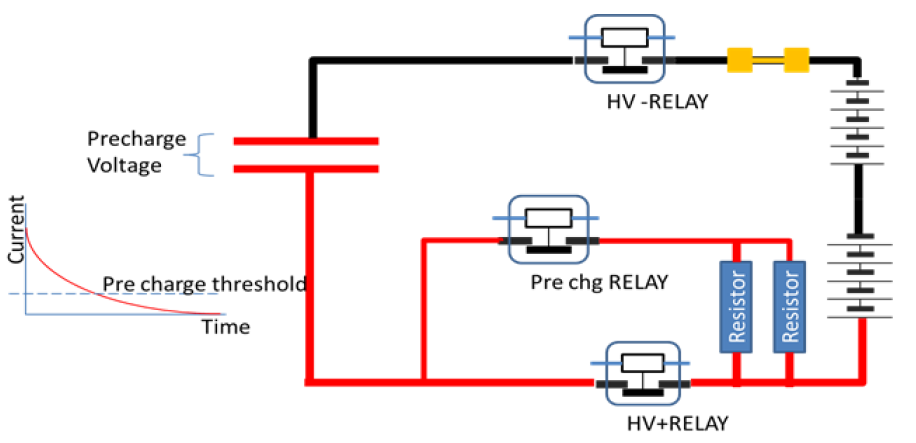
DOC/Conception/Images/SchemaCourbePrecharge.png
