chrisdsa/BMS/DOC/Conception/Images/Shunt.png

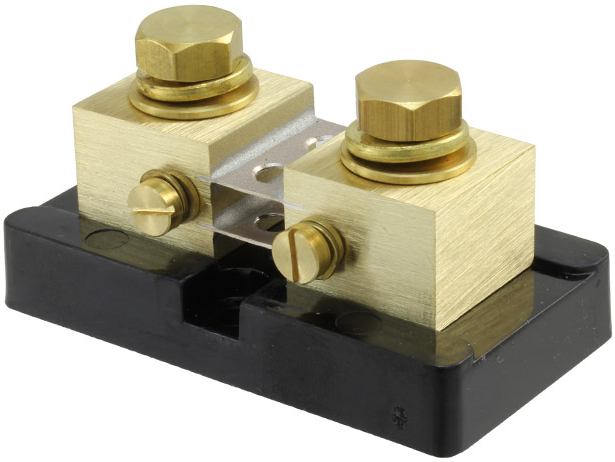
DOC/Conception/Images/Shunt.png
