chrisdsa/BMS/DOC/Conception/Images/Tension_module.png

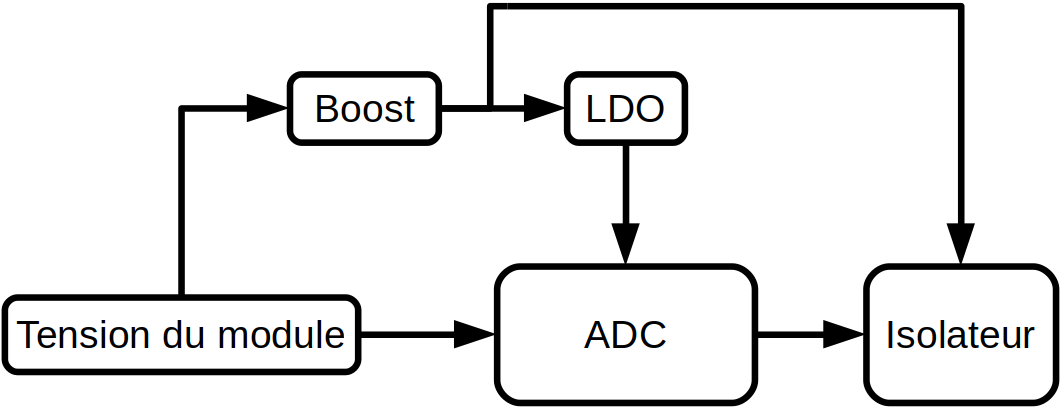
DOC/Conception/Images/Tension_module.png
