chrisdsa/BMS/DOC/Conception/Images/Voltage_reference.png

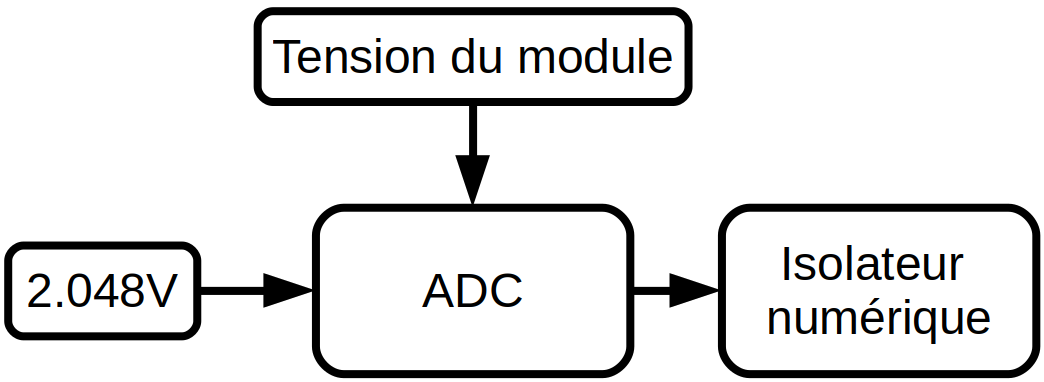
DOC/Conception/Images/Voltage_reference.png
