chrisdsa/BMS/DOC/Proposition de projet/images/ETS-rouge-ecran-fond_transparent.png

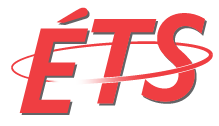
DOC/Proposition de projet/images/ETS-rouge-ecran-fond_transparent.png
