chrisdsa/BMS/DOC/Conception/Connecteur Wurth.ods

Wurth Standard "Molex" Connectors |  |  | CAN Connector
4.20 mm Mini Power Connectors | WR-MPC4 |  | 649 006 227 22
Description | Order Code | Mates with
Dual Row Male Vertical Header | 649 0xx 211 22 | 6490xx113322 | 6 | 5 | 4
Dual Row Male Vertical Header with snap-in plastic | 649 0xx 221 732 | 6490xx113322 | Shield | VCC | CANH
Dual Row Male Right Angled Header | 649 0xx 295 22 | 6490xx113322 | Shield | CANL | GND
Dual Row Male Right Angled Header with snap-in plastic | 649 0xx 227 22 | 6490xx113322 | 3 | 2 | 1
Pin (Female) | AWG | Qty
649 105 137 22 | 16 | 200 | As seen from the plugged connector
649 106 137 22 | 24-18 | 200
649 107 137 22 | 28-22 | 500
Pin (Male) | AWG | Qty
649 108 137 22 | 16 | 200
649 109 137 22 | 24-18 | 200
649 100 137 22 | 28-22 | 500
Tool | Crimp
600003 | 600649326160
3.00 MM Micro Power connectors | WR-MPC3
Description | Order Code | Mates with
Dual Row Male Vertical Header | 662 0xx 211 22 | 6620xx1133220
Dual Row Male Right Angled Header with snap-in | 662 0xx 210 22 | 6620xx1133220
Pin (Female) | AWG | Qty
662 101 137 22 | 24-20 | 1000
Pin (Male) | AWG | Qty
649 108 137 22 | 24-20 | 1000
Tool | Crimp
600003 | 600662324200
