chrisdsa/BMS/DOC/Plan de test/Detection_et_gestion_des_fautes/polarite_inverse_module.tex

\section{Validation de la protection de polarité inverse d'un module}

	% Objectif et critère de réussite
	\begin{description}
		\item[Objectif :] Valider la protection à l'entrée du circuit de mesure de la tension d'un module.
		\item[Critère de réussite :] Obtenir une différence de potentiel nul sur l'alimentation du ADC.
	\end{description}
	
	% Équipement nécessaire
	\subsection*{Équipements nécessaires}
	\begin{enumerate}
		\item Source de tension ajustable de 0V à 5V ou plus;
		\item Multimètre avec une précision d'au moins 1mV;
	\end{enumerate}	
	
	% Procédure de test
	\subsection*{Procédure de test}
	\begin{enumerate}
		\item Connecter la source à 4V aux bornes inversées du circuit de lecture de tension d'un module;
		\item Mesurer le potentiel aux bornes de l'alimentation du ADC.
	\end{enumerate}
