chrisdsa/BMS/DOC/Plan de test/Lecture_parametres/lecture_tension.tex

\section{Validation de la résolution de la lecture de tension d'un module}

	% Objectif et critère de réussite
	\begin{description}
		\item[Objectif :] Valider la précision de la lecture de tension sur toute la plage.
		\item[Critère de réussite :] Obtenir une résolution de minimum $\pm 10 \text{mV}$.
	\end{description}

	% Équipement nécessaire
	\subsection*{Équipements nécessaires}
	\begin{enumerate}
		\item Source de tension ajustable de 0V à 5V ou plus;
		\item Multimètre avec une précision d'au moins 1mV;
	\end{enumerate}	

	% Procédure de test
	\subsection*{Procédure de test}
	\begin{enumerate}
		\item Connecter la source à 0V aux bornes du circuit de lecture de tension d'un module;
		\item Faire varier la source de 0V à 4.8V, noter chaque valeur de la source et celle donnée par le système de protection de batterie.
	\end{enumerate}
