chrisdsa/BMS/DOC/Plan de test/Communication/comm_master_slave.tex

\section{Communication des modules esclaves}

	% Objectif et critère de réussite
	\begin{description}
		\item[Objectif :] Tester la communication des modules esclaves.
		\item[Critère de réussite :] Nombres d'erreurs inférieur à la limite permise et une vitesse de transmission à l'intérieur de la tolérance permise.
	\end{description}
	
	% Équipement nécessaire
	\subsection*{Équipements nécessaires}
	\begin{enumerate}
		\item Source de tension;
		\item CANanalyseur;
		\item Ordinateur;		
	\end{enumerate}	
	
	% Procédure de test
	\subsection*{Procédure de test}
	\begin{enumerate}
		\item Brancher la source de tension au module esclave pour l'alimenter;
		\item Brancher le CANanalyzer à l'ordinateur;
		\item Brancher le CANanalyzer sur le module esclave;		
		\item Envoyer une communication test vers le module esclave;
		\item Recevoir une réponse du module esclave pour chaque message;
		\item Noter le nombre d'erreurs; 
		\item Noter la vitesse de transfert;
		\item Recommencer les étapes précédentes avec tous les modules esclaves;
		
	\end{enumerate}
