chrisdsa/BMS/(threads)

Thread 1 (2017-03-15):

Proposition du projet

chrisdsa, 2017-03-15:
Remplir le document dans le Drive
- [x] Objectif
- [x] Moyens
- [x] Méthodologie
- [x] Mettre le document au propre
- [x] Relecture
- [x] Envoyer le texte
- [x] Signature du professeur
- [x] Remise du document au département
- [x] Approbation du Directeur

bourassajulien, 2017-03-20:
Est-ce qu'on met la liste des logiciels ou c'est pas vraiment pertinent pour la proposition?

chrisdsa, 2017-03-20:
Je ne la mettrais pas, on en parle déjà un peu dans les autres points.

bourassajulien, 2017-03-23:
J'ai enlevé la mention du "nous" dans le texte. On m'a dit que c'était à proscrire dans les rapports.

chrisdsa, 2017-03-24:
J'ai envoyé le texte au prof, j'attend ses commentaires.

Closed 2017-04-07.

Thread 2 (2017-03-19):

Étudier la faisabilité d'utiliser nOS

chrisdsa, 2017-03-19:
Conclusion : nOS va être utilisé

bourassajulien, 2017-03-20:
Documentation: https://github.com/jimtremblay/nOS

chrisdsa, 2017-04-12:
Ta tu un update sur l'utilisation de nOS. Pour le cahier des charges on va en parler.

oclarocque, 2017-04-15:
Oui, on va pouvoir l'utiliser. Je vais aussi utiliser le OS abstraction layer de la NASA.

chrisdsa, 2017-04-15:
nice!

Closed 2017-04-15.

Thread 3 (2017-03-23):

Revoir méthodologie - Cahier des charges

bourassajulien, 2017-03-23:
Je crois que le cahier des charges c'est plus ce qu'on explique dans la synthèse. Comme vérifier les besoins et dire c'est quel outil a utiliser.
Il faudrait relire ELE400 pour ca.
Mais je crois pas qu'on va se faire refuser pour ca.

chrisdsa, 2017-03-24:
Le cahier des charges :
1. Contexte et définition du problème
2. Objectif
3. Périmètre (limites)
4. Description fonctionnelle
5. Moyens
6. Échéancier
Source : https://www.manager-go.com/gestion-de-projet/dossiers-methodes/elaborer-un-cdc

chrisdsa, 2017-04-02:
On est bon avec cette structure pour le cahier des charges?

Closed 2017-05-02.

Thread 7 (2017-04-07):

Étudier les besoins et établir les prioritées

chrisdsa, 2017-04-07:
### Editer un fichier .tex pour chaque besoin avec, si applicable:
1. Priorité
2. Contexte et définition du problème
3. Objectif
4. Périmètre (limites)
5. Description fonctionnelle
6. Spécification détaillée
7. Ressources
8. Idées de conception

chrisdsa, 2017-05-04:
Cette tâche est en progrès dans les différentes tâches du cahiers des charges

Closed 2017-05-04.

Thread 8 (2017-04-26):

Réunion de lancement ( Kick off meeting)

chrisdsa, 2017-04-26:
**Réunion de lancement**
Quand : Lundi le 1er Mai  15h (Montréal)
Ou : Telegram

**Objectif** : Discuter du cahier des charges et des différents points de vue du projet

**Points à discuter** :
* Définir un road map global, incluant tous side projects nécessaires (e.g. simulateur de cellule)
* Discuter de la répartition des tâches de développement pour que les membres se préparent en conséquence (études des méthodologies, des logiciels, des technologies..)
* Définir les objectifs et le degré de complexité (pour le cours et la compétition)
* Horaire des membres et disponibilités
* Meeting entre les membres
* Meeting avec le professeur
* Gestion du budget (sur quoi on met les ressources)
* Gestion de projet (gantt? division en semaine)
* Recherche documentation et partage des connaissances
* Schéma bloc du projet

Voir issue `Revoir méthodologie - Cahier des charges #3` pour la description du cahier des charges

oclarocque, 2017-04-30:
*Définir un road map global, incluant tous side projects nécessaires (e.g. simulateur de cellule)
*Discuter de la répartition des tâches de développement pour que les membres se préparent en conséquence (études des méthodologies, des logiciels, des technologies..)

bourassajulien, 2017-05-01:
* Horaire des membres et disponibilités
* Meeting entre les membres
* Meeting avec le professeur
* Gestion du budget (sur quoi on met les ressources)
* Gestion de projet (gantt? division en semaine)
* Recherche documentation et partage des connaissances
* Schéma bloc du projet

Closed 2017-05-03.

Thread 10 (2017-05-02):

Contexte et définition

bourassajulien, 2017-05-02:
- [x] Danger des battries Li-ion
- [x] Système de protection et de gestion de batterie
- [x] Projet spécial
- [x] Club étudiant Éclipse
- [x] Compétitions

chrisdsa, 2017-05-05:
Un point important a mettre dans le contexte serait la distinction entre le système de protection de batterie (BPS) et le système de gestion (BMS)

Closed 2017-05-20.

Thread 11 (2017-05-02):

Objectifs

chrisdsa, 2017-05-02:
Les objectifs sont en ordre de priorité.

### MVP
1.  Battery Protection System

2.  Balancement des modules

3. Être compatible avec le BMS présentement utilisé dans Éclipse IX (Lithiumbalance)
http://www.lithiumbalance.com/en/component/product/categories/19?sid=37

4. Faciliter le scrutineering

### Extra

5. Active cooling (Contrôle des fans du batterie pack)

6. Calcul du SOC

7. Limites dynamique

8. Envoyer les mesures sur un serveur / internet mesure lorsque le batterie pack est entreposé

Closed 2017-05-20.

Thread 13 (2017-05-03):

Ajouter section des risques et méthode mitigation.

bourassajulien, 2017-05-03:
On peut rajouter les risques comme dans le chapitre 2.4 du livre A Systems Approach.
On élimine ceux qui s'appliquent pas au projet et comment on va attaquer les autres.
Je ne sais pas si c'est mieux de le mettre dans le cahier des charges ou de conception par contre.

chrisdsa, 2017-05-03:
Faudrait assigner des priorités aux risques et les inclure dans les objectifs

chrisdsa, 2017-05-03:
Une autre section intéressante, chapitre 17 : **Fault Detection**
1. Overcharge/Overvoltage
2. Over-Temperature
3. Overcurrent
4. Battery imbalance / Excessive Self-Discharge
5. Internal Short Circuit Detection
6. Detection of lithium plating
7. Venting Detection
8. Excessive Capacity Loss

Il parlait aussi dans le livre comment vérifier les différents périphériques. On testerais le relais, la shunt lors de la pré charge, il a des méthodes pour contre valider que les lectures sont bonne en regardant l'ensemble des autres lecture etc. Je peux ajouter ça dans les objectifs :
- Diagnostique des périphériques / sensors
- Contre validation des lectures (améliore la robustesse)
Personnellement je mettrais ça dans les extras

Closed 2017-05-20.

Thread 14 (2017-05-05):

Description fonctionnelle

chrisdsa, 2017-05-05:
### MVP
1.  Battery Protection System
a. Over-charge
b. Over-discharge
c. Over-current
d. Over-temperature

2.  Balancement des modules
a. Passive Top-Balancing

3. Être compatible avec le BMS présentement utilisé dans Éclipse IX (Lithiumbalance)
http://www.lithiumbalance.com/en/component/product/categories/19?sid=37
a. Communication sur le CAN
b. Contrôle du relais de pré-charge

4. Faciliter le scrutineering

### Compétition ASC 2018

5. Active cooling (Contrôle des fans du batterie pack)

6. Calcul du SOC

7. Limites dynamique

8. Envoyer les mesures sur un serveur / internet mesure lorsque le batterie pack est entreposé

Closed 2017-05-20.

Thread 15 (2017-05-09):

Cahier de conception

bourassajulien, 2017-05-09:
Décomposition du problème en sous-problèmes
Recherche d’idées de solution
Élaboration de concepts
Analyse de faisabilité des concepts (pour éliminer les risques technologiques)
Choix final d’un concept de solution (Matrice)

Livrables:
diagramme fonctionnel
Représentation graphique de l’ensemble des fonctions qui doivent être remplies par les composants du produit développé.

Recherche d’idées
Paragraphe qui décrit la procédure de recherche des idées et qui résume les idées produites.

Tableau synthèse des concepts
Tableau qui décrit les concepts d’une façon générale.

matrice de décision
Résultat de l’analyse des concepts en regard des aspects physiques, économiques, temporels et socioenvironnementaux associés au projet.

Thread 23 (2017-05-24):

Conception - Shunt voltage sense

bourassajulien, 2017-05-24:

chrisdsa, 2017-05-26:
PGA differentiel : PGA281AIPWR
ADC : STM32F446 ou le meme que pour les modules (ADC121S021CIMF/NOPBCT-ND),
ADC Diff : ADS7044IDCUR (12Bits), ADC141S626CIMM (14Bits)
Alimentation +12 / -12 Isolée : PH02D2412A

Thread 24 (2017-05-26):

Prototype lecture de tension et balancement

chrisdsa, 2017-05-26:

chrisdsa, 2017-05-26:
PCB envoyé au tech à l'école et chez Itead (Tech ne répond pas au telephone, c'est trop long)

chrisdsa, 2017-05-26:
Ajouter dans la version finale une LED en parallele avec la resistance de bleed

Closed 2017-06-10.

Thread 28 (2017-06-01):

Veille Technologique: BMS

bourassajulien, 2017-06-01:
Veille Technologique de BMS complet

Open Source
Battery Monitor
https://github.com/simat/BatteryMonitor
Ne fais que monitorer des batteries avec un Beaglebone
•	Beaglebone
•	Texas Instruments ADS1115 16 bit A/D converters

ElectroDacus
http://electrodacus.com/
Système PV
 

OpenBMS
https://github.com/rickygu/openBMS
based on the Linear Tech LTC6802-2 integrated IC and Cinch ModICE automotive enclosure.
Master Board Features
•	Arduino Micro-controller
•	Low Voltage Protection
•	High Voltage Protection
•	LCD Display
•	Hall Effect Isolated Current Sensor
•	Coulomb Counting
Daughter Board Features
•	Measures up to 12 Li-Ion Cells in Series (60V Max)
•	Stackable Architecture Enables >1000V Systems
•	0.25% Maximum Total Measurement Error
•	13ms to Measure All Cells in a System
•	Cell Balancing:
•	On-Chip Passive Cell Balancing
•	Two Thermistor Inputs Plus On-Board Temperature Sensor
•	1MHz Daisy-Chainable Serial Interface
•	High EMI Immunity
•	Delta Sigma Converter with Built-In Noise Filter
•	Open Wire Connection Fault Detection
•	Low Power Modes
 
FoxBMS
https://www.foxbms.org/typo3/index.php?id=foxbms
https://foxbms.readthedocs.io/en/release-0.4.x/
https://github.com/foxBMS/foxBMS-documentation

OFS BMS

Lithium Balance
Tritium
Orion BMS
Chargery
Elektromotus
Elithion: Lithiumate Lite, Lithiumate Pro
Ewert Energy Systems: Orion BMS
Guantuo
Ligoo / Anhui / Wicom
Manzanita Micro
Pacific EV

Thread 31 (2017-06-17):

Conception: Contacteur Gigavac

bourassajulien, 2017-06-17:
Contacteurs GIGAVAC_HX21
http://www.gigavac.com/sites/default/files/hx21.pdf

Pick-Up current, Max (75ms): 4.3A

Safety current: 4.3A * 1.2 = 5.16A

Gate drive: 3.3V

Solution 1:
1 Mosfet N-Channel high-side
3 Mosfet P-Channel low side

Solution 2
Solid State Relay
4 Solid State Relay
BJT pour driver la led: BC849BLT1G
http://www.ixysic.com/home/pdfs.nsf/www/CPC1907B.pdf/$file/CPC1907B.pdf

Solution 3:
Opto + Relais

http://www.ixysic.com/home/pdfs.nsf/www/CPC1002N.pdf/$file/CPC1002N.pdf
