chrisdsa/BMS/(commit log)

2017-03-19 working on proposition de projet
2017-03-20 Modification Prototype
    Redondance, on en parlait plus en détail dans budget.
2017-03-21 ajout des noms des logiciels dans l'enumeration
2017-03-23 Modifs
    - Enlevé la mention de "nous"
    - mini modifs
2017-03-23 Modifs
    - Suppressions des instances "nous"
2017-03-23 modifs
    - Suppression de la mention "nous"
    - Quelques reformulations
2017-04-26 add note to cell voltage reading
2017-05-05 rename folder to Cahier de Charge
2017-05-05 Ajout de section: Club étudiant Éclipse
2017-05-05 Ajout de section: Système de protection
2017-05-05 Ajout de section: Projet spécial
2017-05-08 add redundant ADC option
2017-05-14 docs: cahier_de_charge: Add Methodes de travail section
2017-05-16 update for kicad
2017-05-16 SCH ADC part done
    [Lecture_Tension.sch]
2017-05-16 sch done, need review
    [Lecture_Tension.sch]
2017-05-17 need tension divider LDO
    [Lecture_Tension.sch]
2017-05-17 complete VRef regulator
    [Lecture_Tension.sch]
2017-05-17 add ADR0-1 header
    [Lecture_Tension.sch]
2017-05-17 remove prototype section
    [Lecture_Tension.kicad_pcb, Lecture_Tension.sch]
2017-05-21 Added Master + Current sense
2017-05-22 Modified: Master + Lecture de courant
2017-05-23 Ajout: Page de l'architecture générale
2017-05-25 add text CAN bus to slave architecture diagram
2017-05-28 add +/- 15V supply
2017-06-11 Add file connecteur wurth
    [Connecteur Wurth.ods]
2017-06-11 Add CAN setup
    [Connecteur Wurth.ods]
2017-06-25 Objectif : Protection des modules
2017-06-25 add simulation for adc reading VREF
2017-06-26 ADC Vref complete
2017-06-27 Lecture tension module complete
2017-06-29 Add schematics for contactor solution
2017-06-30 add picture current sense
2017-06-30 lecture temperature terminer
2017-06-30 detection des erreurs complet
2017-06-30 Add section Compatibility
    [C22BmsEclipse.ods, C22LithiumBalance.ods]
2017-07-01 Add section diagramme slave + currentsense
2017-08-04 Add first draft Cahier de Realisation
2017-08-04 Modify tex doc Rappel des objectifs
2017-08-07 Add image of boards
2017-08-07 Modify section conclusion
    [Connecteur Wurth.ods]
2017-10-08 Add BMS background
2017-10-23 Complete BMS background
